ishaaqdev/IWM-Reverse-Vending-Machine/Media/showcase images/rvm4.jpeg

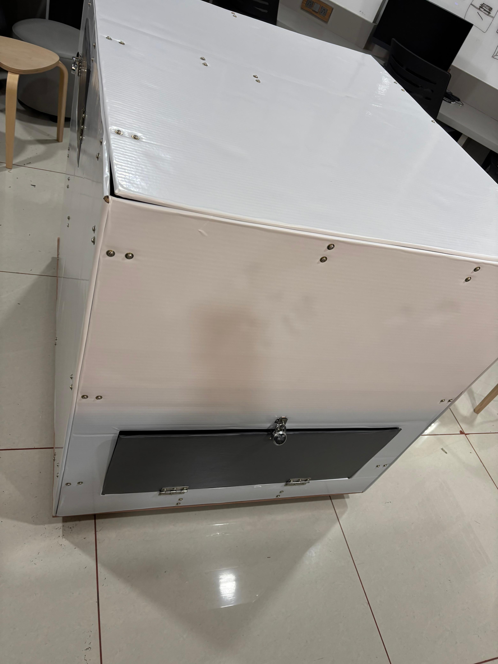
Media/showcase images/rvm4.jpeg
