ishaaqdev/IWM-Reverse-Vending-Machine/Media/showcase images/rvm 5.jpeg

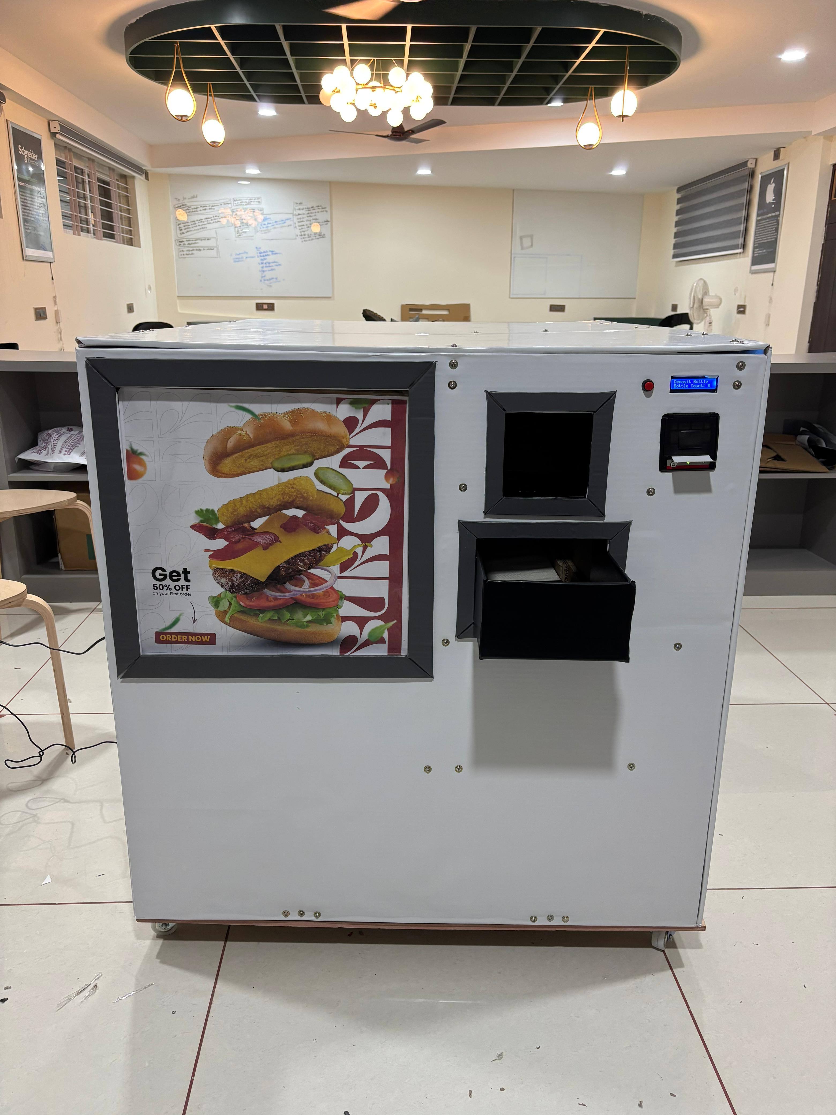
Media/showcase images/rvm 5.jpeg
