ishaaqdev/IWM-Reverse-Vending-Machine/IWM_RVM_Technical_Reference.pdf

# INDUS WASTE MANAGEMENT

## Reverse Vending Machine (RVM)

## Technical Reference Document

Project | Reverse Vending Machine — PET Bottle Collection System
Version | Phase 8 (Memory-Optimized with Load Cell Validation)
Platform | Arduino Uno (ATmega328P)
Build Cost | ~■15,000
Recognition | Incubated | JVTM Prize Winner
Semester | 3rd Semester, ISE Engineering

This document provides a complete technical reference for the IWM Reverse Vending Machine prototype built during the 3rd semester of Information Science Engineering. It covers all hardware components, sensor selection rationale, wiring connections, and system architecture to enable reproducibility and further development.

## 1. System Overview

The IWM RVM is an automated machine that accepts PET plastic bottles, validates them through a multi-stage detection pipeline, transports them via conveyor belt, and dispenses a reward coupon to incentivize recycling. The system uses an Arduino Uno as its central controller and integrates ultrasonic detection, material sensing, weight validation, motorized transport, and thermal printing.

## Processing Pipeline

Step | Stage | Component | Action
1 | Bottle Detection | Ultrasonic (HC-SR04) | Detects object within 10 cm of intake
2 | Material Analysis | Inductive + Capacitive | Rejects metal; accepts PET plastic
3 | Weight Validation | Load Cell (HX711) | Accepts 15g – 35g; rejects out-of-range
4 | Conveyor Transport | DC Motor (L298N) | Moves bottle forward toward collection bin
5 | Trapdoor Trigger | Ultrasonic + Servo | Opens trapdoor when bottle reaches end
6 | Coupon Dispensing | Thermal Printer | Prints reward coupon after session ends

## 2. Sensors & Components

Each component was selected for a specific role in the validation pipeline. The table below lists every sensor and module, its purpose, and the design rationale.

Component | Model / Type | Role | Why This Was Chosen
Microcontroller | Arduino Uno (ATmega328P) | Central controller | Widely available, strong community support, sufficient I/O for prototype
Intake Ultrasonic | HC-SR04 | Detect bottle at intake slot | Non-contact, ±3 mm accuracy, low cost; 10 cm threshold filters non-bottle objects
Inductive Sensor | LJ12A3-4-Z/BX (NPN, 4mm) | Detect metal objects | Responds only to conductive metals; rejects cans and foil-lined bottles
Capacitive Sensor | LJC18A3-H-Z/BX (NPN, 8mm) | Confirm plastic/non-metal | Detects dielectric materials; combined with inductive sensor for material ID
Load Cell | 50 kg bar type + HX711 ADC | Validate bottle weight | 15–35 g range catches empty PET bottles and rejects foreign objects or full bottles
DC Motor | 12 V, 300 RPM + L298N Driver | Drive conveyor belt | L298N provides H-bridge control for forward/backward motion and PWM speed
Servo Motor | SG90 / MG90S 9g Micro Servo | Actuate trapdoor | Precise angle control (35°–180°); low torque needed for trapdoor hinge
Trapdoor Ultrasonic | HC-SR04 | Detect bottle at trapdoor | Triggers servo only when bottle is present — prevents false actuations

Component | Model / Type | Role | Why This Was Chosen
Thermal Printer | 58 mm Serial Thermal Printer | Print reward coupon | No ink needed; fast; ESC/POS commands allow bold/normal formatting on 58 mm roll
LCD Display | 16x2 I2C LCD (PCF8574, 0x27) | Real-time status display | I2C reduces pin usage to 2 wires; 16-char width fits all status messages
Buzzer | Active Buzzer 3–5 V | Audio feedback | Distinct beep counts signal accept (2), reject (3), and session end (2) events
Push Button | Momentary NO Button | End session / print coupon | Debounced in firmware; triggers coupon print after multi-bottle session
EEPROM | Built-in ATmega328P | Store calibration factor | Persists load cell calibration across power cycles without external storage

## 3. Pin Connection Reference

All connections are referenced to the Arduino Uno. Power rails: 5V and GND are shared across all logic-level devices. The L298N motor driver and servo use the Arduino's 5V regulated output for logic, with the DC motor powered from an external 12V supply.

## 3.1 Intake Ultrasonic Sensor (HC-SR04 — Bottle Detection)

Sensor Pin | Arduino Pin | Wire Colour (suggested) | Notes
VCC | 5V | Red
GND | GND | Black
TRIG | D4 | Yellow | Output — 10 µs pulse triggers measurement
ECHO | D5 | Green | Input — pulse width proportional to distance

## 3.2 Inductive Proximity Sensor

Sensor Pin | Arduino Pin | Wire Colour (suggested) | Notes
Brown (VCC) | External 5–12V | Red | Check sensor voltage spec before powering
Blue (GND) | GND | Black
Black (OUT) | D2 | White | NPN NO — LOW when metal detected; input with no PULLUP

## 3.3 Capacitive Proximity Sensor

Sensor Pin | Arduino Pin | Wire Colour (suggested) | Notes
Brown (VCC) | External 5–12V | Red | Same supply rail as inductive sensor
Blue (GND) | GND | Black
Black (OUT) | D8 | White | HIGH when non-metal detected within range

## 3.4 Load Cell + HX711 ADC Module

HX711 Pin | Arduino Pin | Wire Colour (suggested) | Notes
VCC | 5V | Red
GND | GND | Black
DT | A1 | Blue | Serial data out from HX711; mapped as DOUT_PIN
SCK | A2 | Yellow | Serial clock; mapped as SCK_PIN
E+/E-/A+/A- | — | — | Connect to load cell wires per HX711 datasheet colour mapping

## 3.5 L298N Motor Driver + DC Conveyor Motor

L298N Pin | Arduino / Power Pin | Notes
ENA | D3 (PWM) | PWM speed control — 255 = full speed
IN1 | D9 | Motor direction bit A
IN2 | D10 | Motor direction bit B — IN1=LOW,IN2=HIGH → Forward
12V | External 12V+ | Motor power supply — do NOT use Arduino 5V here
GND | External GND + Arduino GND (bridged) | Common ground essential
5V OUT | Arduino 5V | Optional: power Arduino logic from L298N onboard reg
OUT1/2 | DC Motor | Motor terminal wires — swap to reverse default direction

## 3.6 Servo Motor (Trapdoor)

Servo Wire | Arduino Pin | Notes
Red (VCC) | 5V | If servo draws >500 mA, use external 5V supply
Brown (GND) | GND
Orange (SIG) | D11 | PWM signal — SERVO_CLOSED=180°, SERVO_OPEN=35°

## 3.7 Trapdoor Ultrasonic Sensor (HC-SR04)

Sensor Pin | Arduino Pin | Notes
VCC | 5V
GND | GND
TRIG | D6 | Second ultrasonic — dedicated to end-of-conveyor detection
ECHO | D7 | Triggers trapdoor servo when distance ≤ 15 cm

## 3.8 Thermal Printer (58 mm Serial)

Printer Pin | Arduino Pin | Notes
VCC | 5–9V ext supply | Most 58 mm printers require 5–9V at up to 2A — use dedicated supply
GND | GND (bridged) | Must share ground with Arduino
RXD | D12 | Printer receive ← Arduino SoftwareSerial TX
TXD | D13 | Printer transmit → Arduino SoftwareSerial RX (optional for status)

## 3.9 16×2 I2C LCD (PCF8574 Backpack)

LCD Pin | Arduino Pin | Notes
VCC | 5V
GND | GND
SDA | A4 | I2C data — shared with other I2C devices if needed
SCL | A5 | I2C clock — default address 0x27; use I2C scanner if different

## 3.10 Buzzer & Button

Component | Arduino Pin | Wiring Notes
Active Buzzer (+) | A3 | Positive lead → A3; negative → GND. HIGH=on, LOW=off
Push Button | A0 | One terminal → A0; other → GND. INPUT_PULLUP mode — LOW when pressed

## 4. Complete Arduino Pin Map (Quick Reference)

Arduino Pin | Type | Connected To | Function
D2 | Digital IN | Inductive Sensor OUT | Metal detection signal
D3 | PWM OUT | L298N ENA | Conveyor motor speed (PWM)
D4 | Digital OUT | HC-SR04 TRIG (intake) | Trigger pulse — bottle detection
D5 | Digital IN | HC-SR04 ECHO (intake) | Echo return — bottle detection
D6 | Digital OUT | HC-SR04 TRIG (trapdoor) | Trigger pulse — trapdoor sensor
D7 | Digital IN | HC-SR04 ECHO (trapdoor) | Echo return — trapdoor sensor
D8 | Digital IN | Capacitive Sensor OUT | Plastic/non-metal detection
D9 | Digital OUT | L298N IN1 | Motor direction bit A
D10 | Digital OUT | L298N IN2 | Motor direction bit B
D11 | PWM OUT | Servo SIG | Trapdoor servo angle control
D12 | SoftSerial RX | Printer TXD | Thermal printer RX (unused in most prints)
D13 | SoftSerial TX | Printer RXD | Thermal printer TX — send ESC/POS commands
A0 | Digital IN | Push Button | Session end trigger (INPUT_PULLUP)
A1 | Analog IN | HX711 DT | Load cell serial data
A2 | Digital OUT | HX711 SCK | Load cell serial clock
A3 | Digital OUT | Active Buzzer | Audio feedback
A4 | I2C SDA | LCD SDA | I2C data (shared bus)
A5 | I2C SCL | LCD SCL | I2C clock (shared bus)
5V | Power | All logic VCC | Regulated 5V output
GND | Power | All GND rails | Common ground

## 4.1 Power Supply Notes

Subsystem | Voltage | Current (approx.) | Source
Arduino Uno | 5V / 7–12V | ~50 mA | USB or DC barrel jack
Sensors (all logic) | 5V | ~80 mA total | Arduino 5V rail
Inductive/Capacitive | 6–36V (NPN) | ~200 mA | Dedicated 12V adapter
DC Conveyor Motor | 12V | ~0.5–1A | External 12V supply → L298N
Servo Motor | 5V | ~200–500 mA | Arduino 5V (or ext. if stalling)
Thermal Printer | 5–9V | Up to 2A | Dedicated 5V/2A adapter

## 5. Software Architecture

## 5.1 Libraries Used

Library | Purpose | Install via
Wire.h | I2C communication for LCD | Built-in (Arduino)
LiquidCrystal_I2C | Drive 16x2 LCD over I2C | Library Manager
Servo.h | PWM servo control | Built-in (Arduino)
SoftwareSerial.h | Serial communication with printer | Built-in (Arduino)
avr/pgmspace.h | Store string constants in Flash (PROGMEM) | Built-in (AVR)
EEPROM.h | Persist load cell calibration factor | Built-in (Arduino)
HX711.h | Read 24-bit ADC from HX711 module | bogde/HX711 (Library Manager)

## 5.2 Memory Optimisations

The ATmega328P has only 2 KB of SRAM. Phase 8 addresses this through: (1) all string literals moved to PROGMEM (Flash) using the PROGMEM attribute and helper functions; (2) variable types downsized to byte where values fit in 8 bits; (3) F() macro used for all Serial.print strings; and (4) averaging load cell readings with filtered outlier rejection to reduce noise without large buffers.

## 5.3 Validation Logic Summary

Check | Pass Condition | Fail Action
Bottle Present | Ultrasonic distance ≤ 10 cm | Wait / ignore
Material | Inductive LOW (≥2/3 reads) | Reject — conveyor reverse 3 s
Weight | 15 g ≤ weight ≤ 35 g | Reject — conveyor reverse 3 s
All Pass | bottle_count++ | Conveyor forward → await trapdoor
Session End | Button press | Print coupon, reset count

## 6. Known Limitations & Future Improvements

Area | Current Limitation | Suggested Improvement
Bottle type | Only PET identified by weight range | Add colour/optical sensor for HDPE vs PET
Connectivity | Standalone, no data logging | Add ESP8266/ESP32 for IoT dashboard
Power | Multiple adapters required | Single 12V supply with step-down for 5V rail
Coupon security | Random 6-digit number only | QR code with timestamp and hash validation

Area | Current Limitation | Suggested Improvement
Load cell drift | Tare on boot only | Periodic auto-tare when no bottle present
Enclosure | Coroplast + screws | Sheet metal or injection-moulded ABS housing

Document prepared for the IWM RVM GitHub repository. Project incubated and awarded the JVTM Prize. Built cost: ~■15,000. All hardware tested on physical prototype.
