ishaaqdev/IWM-Reverse-Vending-Machine/hardware/IWM_RVM_Circuit_schematic.png

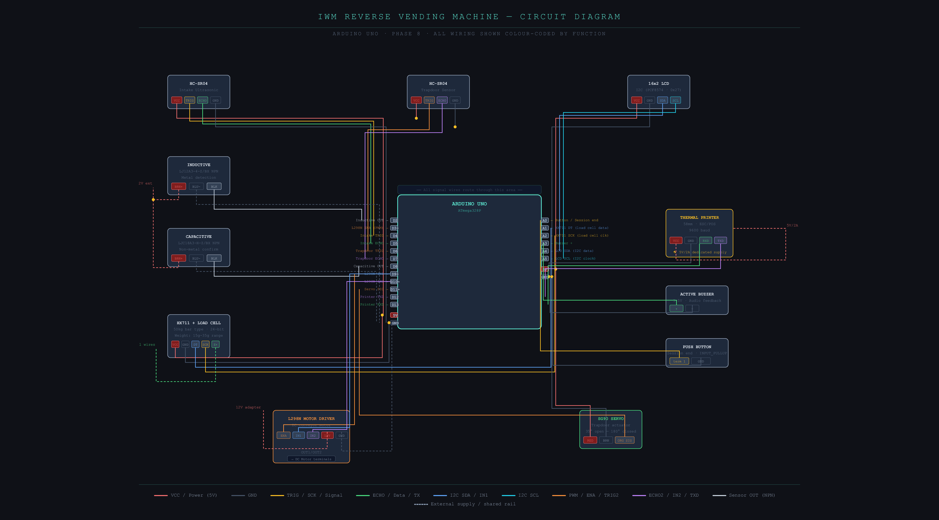
hardware/IWM_RVM_Circuit_schematic.png
