ishaaqdev/IWM-Reverse-Vending-Machine/Media/showcase images/rvm1.jpeg

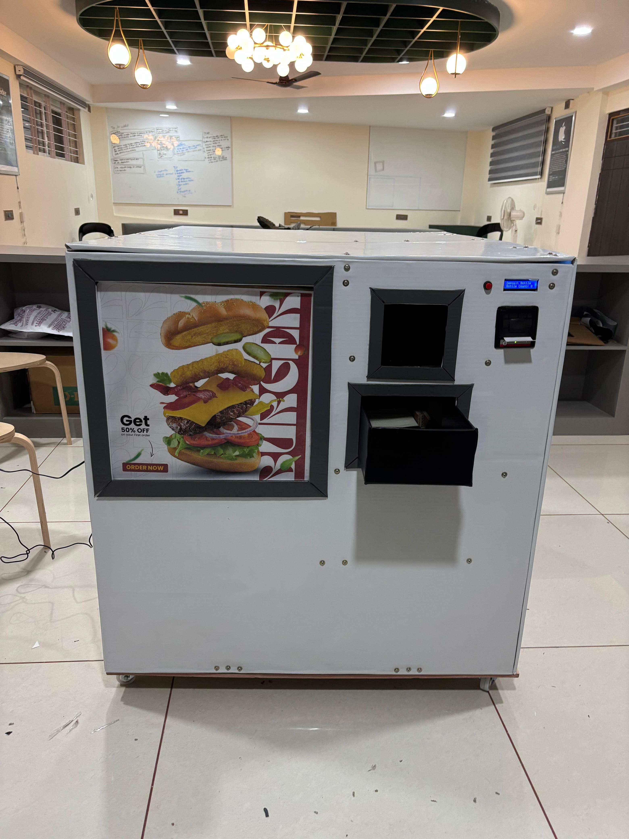
Media/showcase images/rvm1.jpeg
