ishaaqdev/IWM-Reverse-Vending-Machine/Media/showcase images/rvm2.jpeg

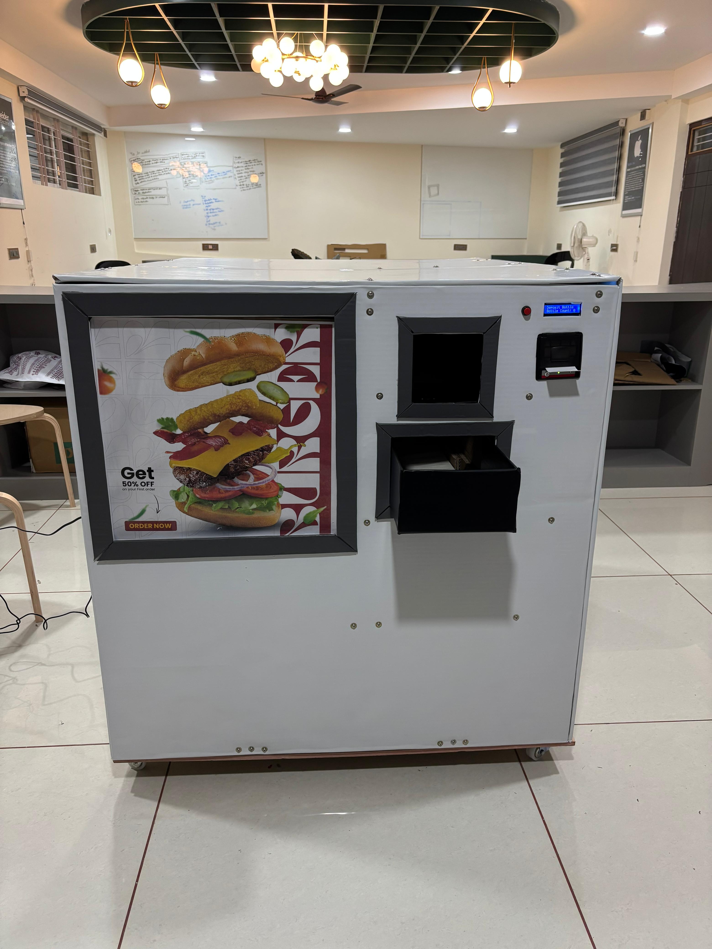
Media/showcase images/rvm2.jpeg
