ishaaqdev/IWM-Reverse-Vending-Machine/Media/showcase images/rvm3.jpeg

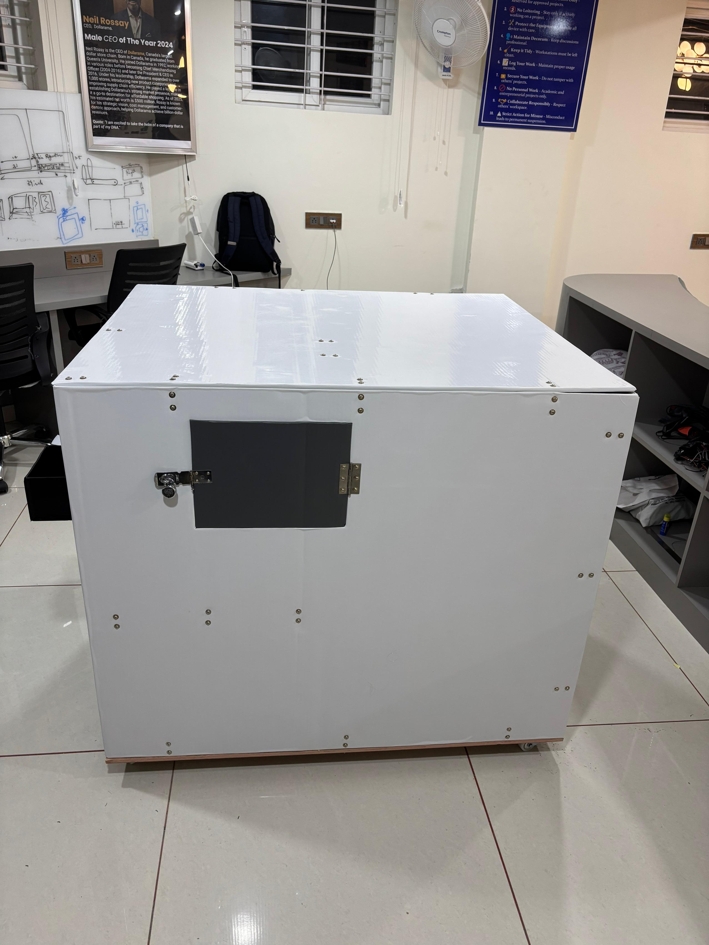
Media/showcase images/rvm3.jpeg
