ishaaqdev/IWM-Reverse-Vending-Machine/Media/showcase images/rvm5.jpeg

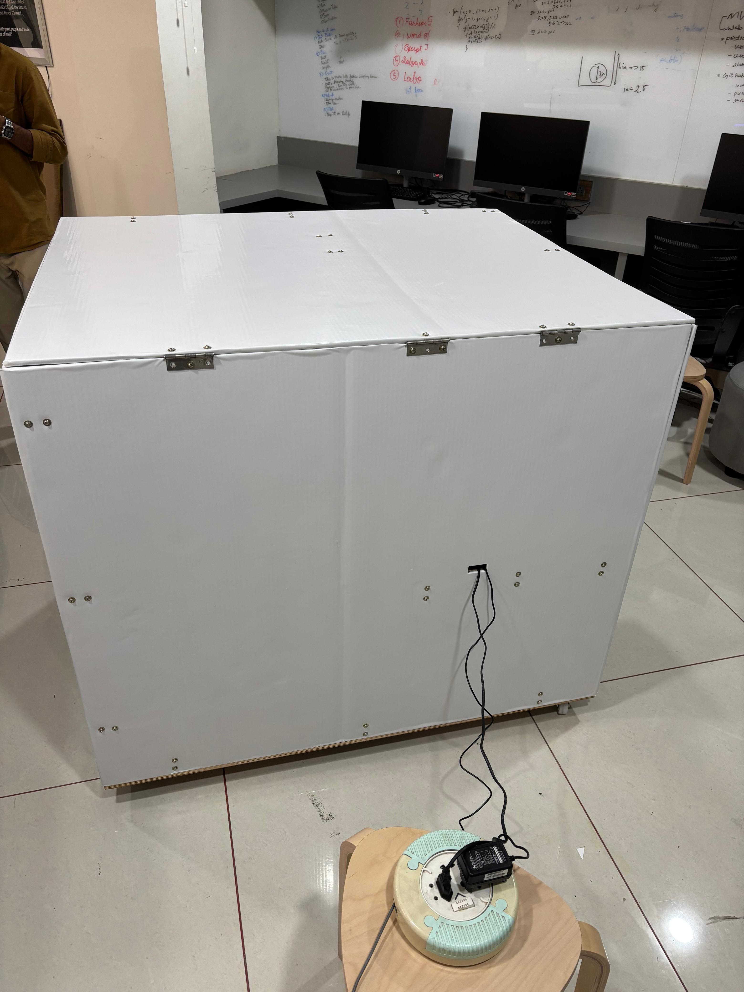
Media/showcase images/rvm5.jpeg
