ishaaqdev/IWM-Reverse-Vending-Machine/Media/showcase images/rvm 6.jpeg

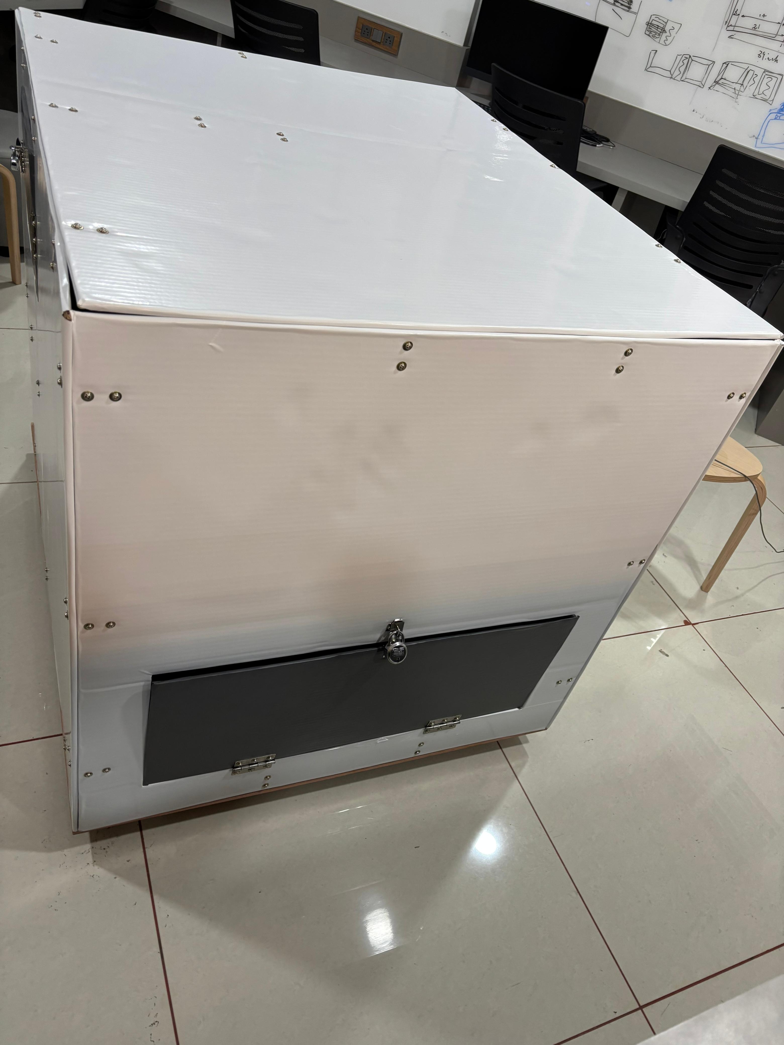
Media/showcase images/rvm 6.jpeg
