ishaaqdev/IWM-Reverse-Vending-Machine/(commit log)

2026-04-24 feat: add project landing page, cleanup repo structure
    - Add docs/ with interactive dark-themed project showcase
    - Remove hardware/index.html (circuit diagram HTML)
    - Remove frontend and index.html (unnecessary files)
    - Update README with tech stack badges, new structure, live site link
    - Website includes: hero, pipeline, tech stack, demo video, gallery, circuit, roadmap
2026-06-09 feat: implement interactive 3D WebGL hardware simulator with Web Audio beeps and thermal printer
2026-06-09 fix: add headlight and front panel lighting, enable OrbitControls after cinematic camera zooms
2026-06-09 feat: add auto-camera tracking toggle, correct conveyor camera view, and implement realistic metro station 3D environment
2026-06-09 feat: add 'See Live Demo' CTA button in hero section
